marcocancarini/x210ai-rp2040-adapter/doc/CONTESTO_20261102.md

# Contesto di lavoro — 02/11/2026 (chiusura sessione)

## Stato
- Branch `main` allineato a origin (`d398215`). Tutto committato e pushato.
- Misure verticali (calibro/monete): connettore tastiera plugged = 2,1 mm (connettore madre + spina +
  flat 0,2 + stiffener 0,36); luce sopra il plugged ~1,8 mm (5 centesimi entra, 10 no); spazio totale
  dal piano scheda madre al fondo tastiera ~3,9 mm; fuori dal connettore ~5,0 mm tra i piani; sopra il
  quadrato bianco < 1 mm (vietato).
- Foto con dima millimetrata in `riferimenti/misure/` (02/11 e 19/10), rettificata in coordinate dima
  (origine = centro BTB_R_CONN1, scala 24,07 px/mm dai crocini A/C/D). Parsing elementi: slot SIM =
  colonna x −54..−42, y −12,5..4,3; 3 connettori FPC in alto y −26..−14; quadrato bianco vietato
  39,25 × 33 mm (x −27,25..12, y −40,2..−7,2).

## Board C (rev 2.3, in prova) —ape:= integrazione Board A+B, senza cavo eDP
- Si innesta su BTB_R_CONN1 (J2 sotto a 0,0; sopra restano ~1,8 mm → solo PCB sottile), aggira il
  quadrato bianco passando sotto e a sinistra, componenti RP2040 sopra il quadrato (lato opposto a BTB).
- Dime in `doc/`: `x210ai_dima_boardC_1a1.pdf` (v1), `_v2_` (ruotata 90° antiorario, oggetti ruotati
  nelle coordinate dima), `_v3_` (v2 con lati della U tagliati a x = 9 mm, 3 mm sotto la parte superiore
  del quadrato; **v3 è quella buona**, area 2134 mm²), `_v4_` (scartata). Generatore:
  `gen2/gen_dima_giro.py` (`--rot90ccw`, `--v3`, `--v4`). Scala 1:1 verificata (righello 50,09 mm).
- Attenzione: con i nomi corretti, il connettore FPC sinistro risulta a filo (0,00 mm) col braccio R3
  della v3 — da controllare con la prova fisica.

## Prossimi passi
1. Stampare `doc/x210ai_dima_boardC_v3_1a1.pdf` al 100 %, ritagliare, provare su scheda madre
   (frecce rosse al centro di BTB_R_CONN1), verificare FPC sinistro a filo e spazio sopra il quadrato.
2. Se torna, abbozzare il layout della Board C (J2 su BTB, J1 ricettacolo tastiera, RP2040 + flash +
   quarzo + LDO in R4, Q2/Q3/R13/R14, connettore USB) in un nuovo `gen2/design_boardC.py`.
3. Vecchio percorso rev 2.2 (Board A + Board B a scalino + cavo eDP) resta come riferimento in
   `out_boardA/`, `out_boardB/`, `doc/`.
