marcocancarini/x210ai-rp2040-adapter/doc/x210ai_dima_boardC_v4_1a1.pdf

-60

-40

-20

0 | | | 0,4-0,8 mm (~1,8 mm sopra) J2
| | | | BTB_R_CONN1 (spina J2 sotto, a 0,0) | vite
R4 48.5x26.3 | | R1 40.85x16.9 | | | | linguetta vite
| quadrato bianco VIETATO (<1 mm sopra), | 39,3 x 33 mm | | | | connettore | CN1

20

40

R3 14.45x56.7 | R2 7.65x3.4 | flat arancione
| | connettore | FPC
centro BTB_R_CONN1 qui (0,0) | sopra BTB_R_CONN1: solo PCB

slot SIM

50 mm: controlla con il calibro dopo la stampa

Dima di prova 1:1 - Board C (rev 2.3, forma C4): scheda unica a giro del quadrato bianco, coordinate dima mm

Origine (0,0) = centro di BTB_R_CONN1, x verso il palmrest (-x), y verso la vite (+y).

1. Stampa al 100% (senza 'adatta alla pagina') e controlla il righello da 50 mm col calibro.
2. Ritaglia lungo il bordo nero spesso (tieni il pezzo interno).
3. Togli la tastiera. Appoggia il ritaglio con le frecce rosse puntate al centro di BTB_R_CONN1.
4. Il ritaglio NON deve coprire: quadrato bianco (rosso, vietato), FPC, flat, CN1, vite,

linguetta, slot SIM (arancione). Deve coprire solo BTB_R_CONN1 (verde, J2 sotto a 0,0).

5. Sopra BTB_R_CONN1 (tratteggio blu) solo PCB: restano ~1,8 mm; poi prova a rimontare la tastiera.

## X210Ai - dima Board C v2 (forma C4, ruotata 90 gradi antiorario), rev 2.3
