marcocancarini/x210ai-rp2040-adapter/doc/x210ai_cornice_misura_1a1.pdf

Cornice di misura 1:1 per fotografare la zona di BTB_R_CONN1 (coordinate delle dime della Board B, mm)

1. Stampa al 100% (senza 'adatta alla pagina') e controlla il righello da 50 mm col calibro.
2. Ritaglia il bordo esterno e la finestra tratteggiata.
3. Togli la tastiera. Appoggia la cornice sulla scheda madre con BTB_R_CONN1 orizzontale, lo slot SIM

a sinistra e la vite in basso, come nelle dime: il centro del connettore all'incrocio delle frecce rosse

(tacche 0), il lato lungo del connettore parallelo ai righelli in alto e in basso. Fissala con nastro.

4. Fotografa dall'alto, perpendicolare, da 25-30 cm, senza flash e senza ombre: devono vedersi tutta la

cornice, i 4 crocini A-D e i bordi di slot SIM, foro della vite, quadrato bianco e componenti vicini.

Se puoi, fai anche una seconda foto un po' piu' vicina, sempre perpendicolare.

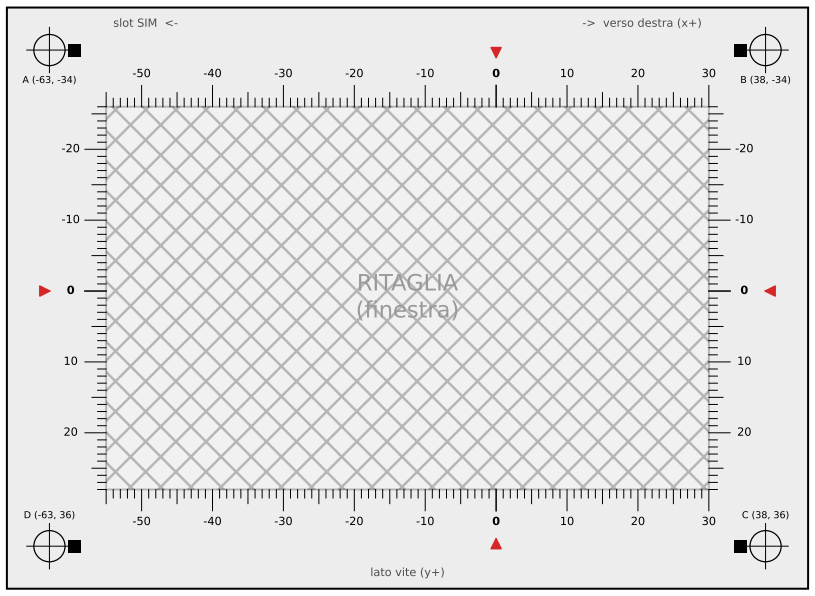
[picture p9: figure]
RITAGLIA (finestra); slot SIM <-; -> verso destra (x+); lato vite (y+)

50 mm: controlla con il calibro dopo la stampa
