marcocancarini/x210ai-rp2040-adapter/doc/x210ai_dima_boardB_scalino_1a1.pdf

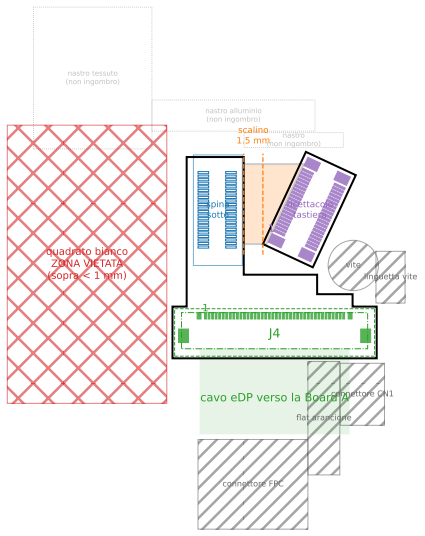
[picture p10: figure]
nastro alluminio (non ingombro); nastro (non ingombro); nastro tessuto (non ingombro); connettore FPC; flat arancione; vite; linguetta vite; connettore CN1; quadrato bianco ZONA VIETATA (sopra < 1 mm); cavo eDP verso la Board A; scalino 1.5 mm; spina sotto; ricettacolo tastiera

scalino
1.5 mm

spina
sotto

J4

1

1

ricettacolo
tastiera

## X210Ai rev 2.2 - dima 1:1 Board B, variante a scalino (palmrest in basso)

PROVA MECCANICA, circuito invariato. Ingombri dalla seconda foto della cornice di misura (28/10).

Orientamento: scheda madre vista dall'alto con il palmrest in BASSO; BTB_R_CONN1 e J4 verticali.

nero: gradino alto (28.8 x 28.4 mm) sulla spina in BTB_R_CONN1 (blu), J4 in basso (verso il palmrest);

arancio: scalino flessibile, scende di 1.5 mm in 2.7 mm (piega a S tra le linee tratteggiate);

viola: ricettacolo della tastiera sul gradino basso, a destra, appoggiato sulla scheda madre, 25 gradi in senso orario;

verde: J4 eDP e spina/fascio del cavo; grigio: ingombri; rosso: zona vietata; puntinato: nastri

Legenda completa dei componenti: x210ai_dima_boardB_scalino_legenda.pdf

margini: gradino alto - flat arancione 0.4 mm; gradino basso - vite 1.5 mm; gradino alto - quadrato bianco 0.8 mm; larghezza tratto flessibile 11.3 mm

Copia in basso: ritaglia il contorno nero (scalino compreso), piega a Z sulle linee arancio in modo che

il gradino basso scenda di 1.5 mm, appoggia la parte alta su BTB_R_CONN1 (pin 1 come in serigrafia)

e controlla: niente sopra il quadrato bianco, gradino basso libero accanto alla vite, spina della tastiera

che arriva sul ricettacolo viola,

spazio sopra il gradino basso per spina + flat (circa 2,9 mm dalla scheda madre), spazio sopra J4

(circa 3,0 mm dalla scheda madre) e strada libera per il cavo eDP.

Stampa al 100% (senza 'adatta alla pagina').

da ritagliare (scalino disteso):

palmrest (in basso) 50 mm: controlla con il calibro
