marcocancarini/x210ai-rp2040-adapter/doc/x210ai_dima_boardB_1a1.pdf

slot SIM

vite

quadrato bianco

Q3 R14 Q2 R13

J1

J4 | 1

uscita cavo eDP

50 mm: controlla con il calibro dopo la stampa

## X210Ai rev 2.2 - dima 1:1 Board B

nero: contorno Board B a L 39.7 x 15.4 mm, vista dall'alto (piazzamento PRELIMINARE)

rosso puntinato: ingombro della rev 2.0 (29 mm a sinistra del centro del connettore)

tratteggio grigio: ostacoli misurati dalla foto (slot SIM, vite, quadrato bianco), +/-0,5 mm

blu: J1 sandwich centrato su BTB_R_CONN1 (pieno = sopra, vuoto = spina sotto)

verde chiaro: fascio del cavo eDP (non fa parte della scheda: NON ritagliare)

margini: slot SIM (in x) 0.7 mm; vite (in y) 4.0 mm; quadrato bianco (in y) 1.5 mm; cavo - J1 (in x) 0.5 mm; J4 - J1 (in y) 0.5 mm

Ritaglia il contorno nero e appoggialo con J1 sul connettore (pin 1 come in serigrafia).

verde: ricettacolo eDP 20455-040E, tratteggio = area libera 28,2 x 6,7 mm (barra di sgancio)

grigio: altri componenti (pieno = sopra, vuoto = sotto)

Stampa al 100% (senza 'adatta alla pagina').
