marcocancarini/x210ai-rp2040-adapter/doc/x210ai_dima_boardB_L_1a1.pdf

slot SIM

vite

quadrato bianco

cavo eDP 21 mm

J1

J4

1

Q3 R14 Q2 R13

cavo eDP 21 mm

J1

J4

1

Q3 R14 Q2 R13

## X210Ai rev 2.2 - dima 1:1 Board B, variante a L rovesciata

nero: contorno Board B a L rovesciata, 39.7 x 15.4 mm, vista dall'alto (PROVA MECCANICA, circuito invariato)

rosso puntinato: contorno attuale della Board B (design_boardB.py), per confronto

tratteggio grigio: ostacoli misurati dalla foto (slot SIM, vite, quadrato bianco), +/-0,5 mm

blu: J1 sandwich su BTB_R_CONN1; verde: J4 ruotato 180 gradi, pin 1 a destra

verde tratto-punto: spina innestata; verde chiaro: fascio del cavo che sale a sinistra di J1

margini: slot SIM (in x) 0.7 mm; vite (in y) 4.0 mm; quadrato bianco (in y) 1.5 mm; cavo - J1 (in x) 0.5 mm; J4 - J1 (in y) 0.5 mm

Copia in basso: ritaglia SOLO il contorno nero, appoggia J1 sul connettore (pin 1 come in

serigrafia). Per il cavo ritaglia una striscia di carta larga 21 mm e posala sulla zona verde.

Stampa al 100% (senza 'adatta alla pagina').

da ritagliare:

50 mm: controlla con il calibro dopo la stampa
