marcocancarini/x210ai-rp2040-adapter/pcb_out4/p4_bottom.png

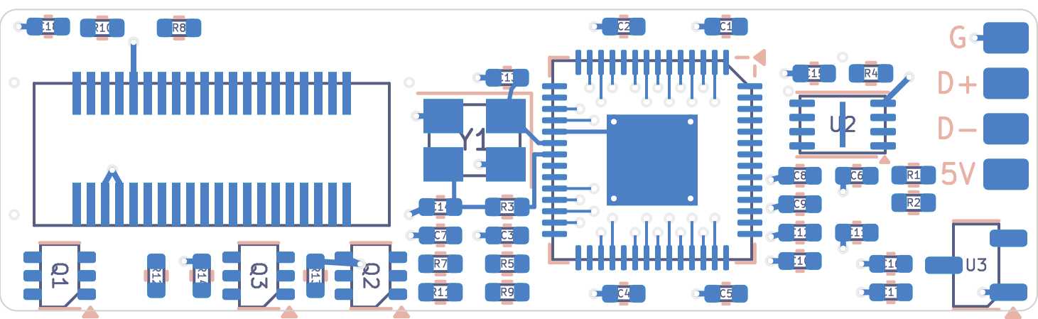
pcb_out4/p4_bottom.png
