marcocancarini/x210ai-rp2040-adapter/riferimenti/misure/foto_20261102_rettificata_mm.jpg

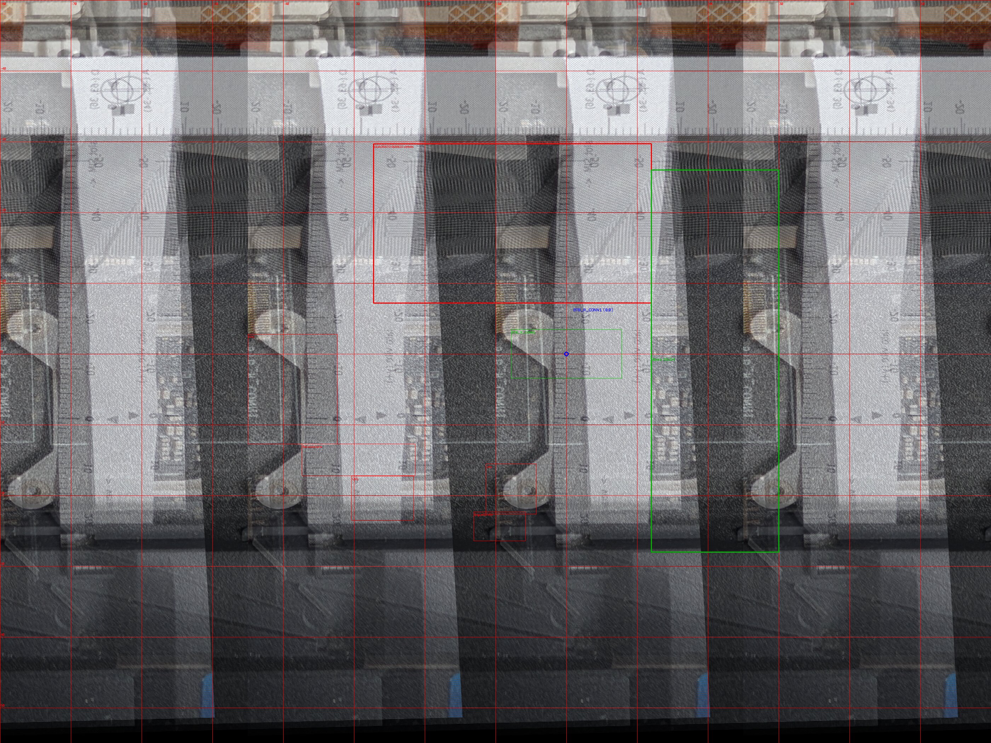
riferimenti/misure/foto_20261102_rettificata_mm.jpg
