marcocancarini/x210ai-rp2040-adapter/riferimenti/misure/PXL_20261019_233538594.jpg

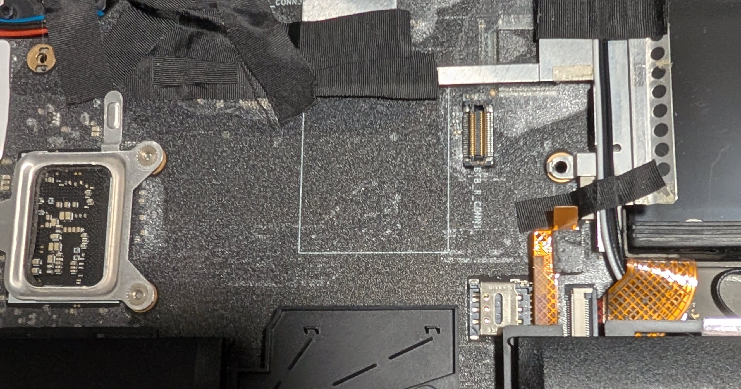
riferimenti/misure/PXL_20261019_233538594.jpg
