marcocancarini/x210ai-rp2040-adapter/riferimenti/misure/PXL_20261102_114706251.jpg

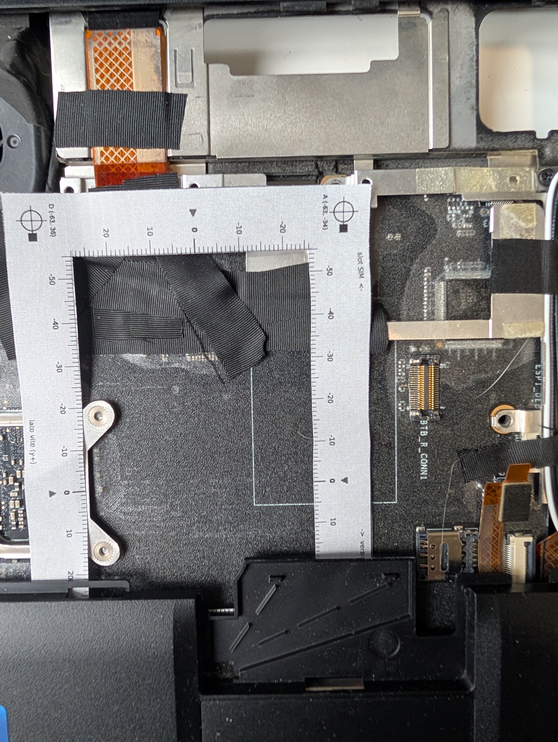
riferimenti/misure/PXL_20261102_114706251.jpg
