marcocancarini/x210ai-rp2040-adapter/sch/sch_prev-1.png

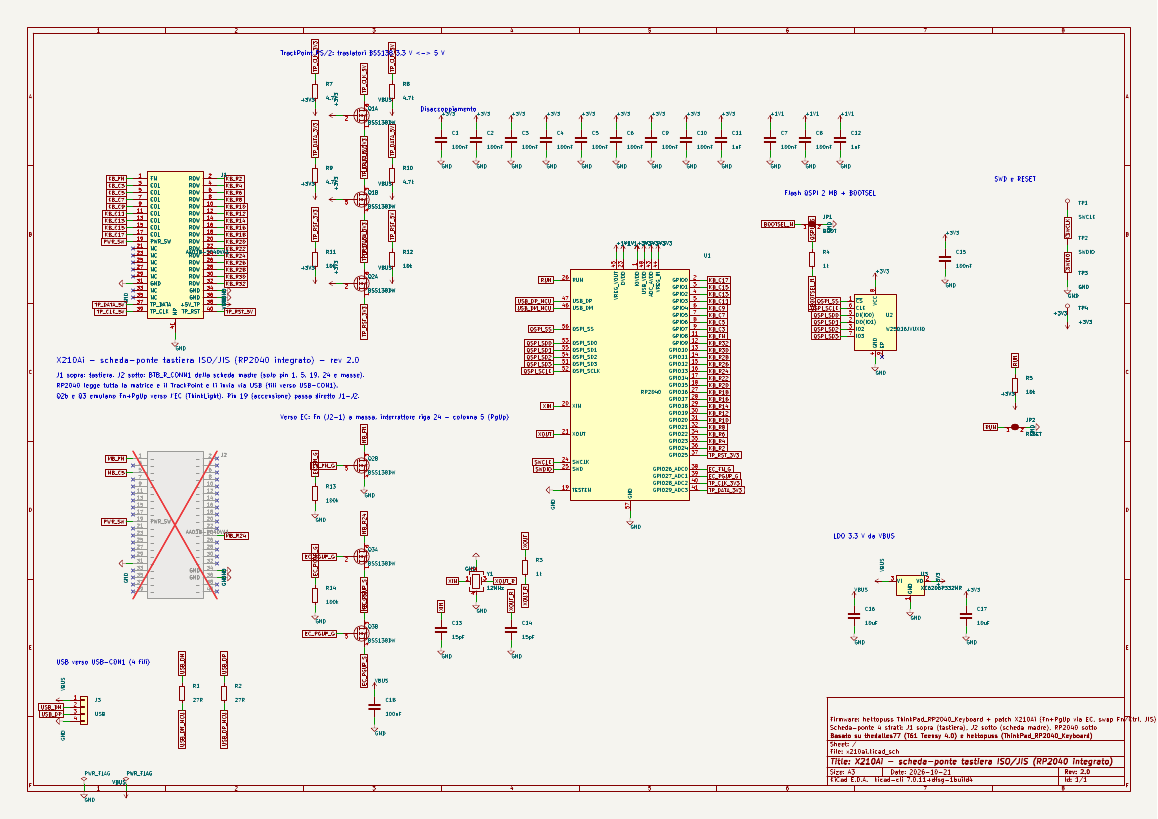
sch/sch_prev-1.png
