marcocancarini/x210ai-rp2040-adapter/spice2/sim_ec_switch.png

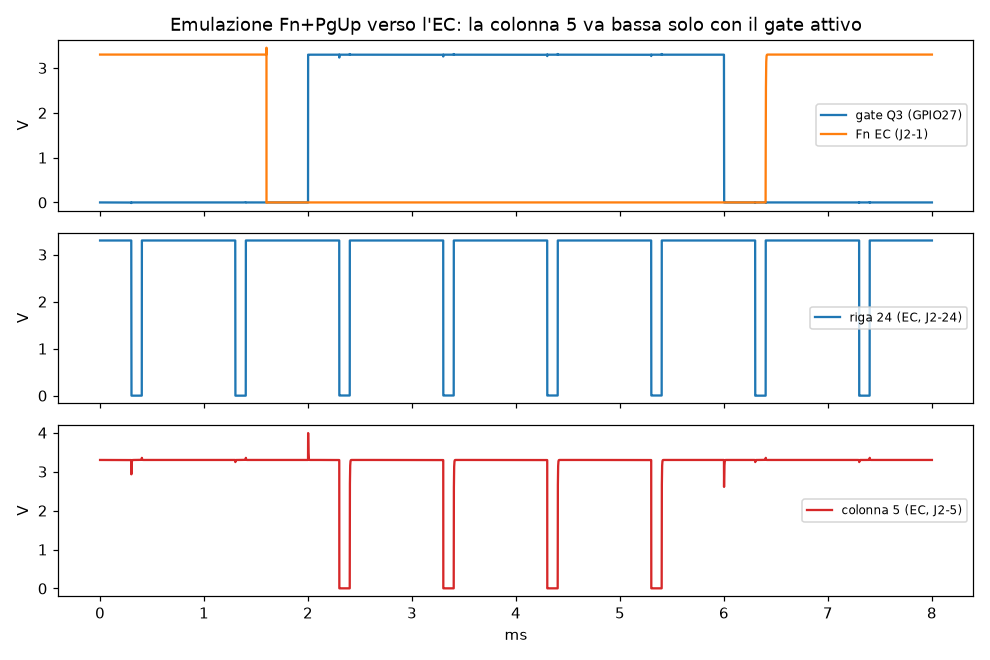
spice2/sim_ec_switch.png
