marcocancarini/x210ai-rp2040-adapter/produzione/boardB/x210ai_rev2.2_boardB_bom_jlcpcb_bottom_e_top.csv

Comment | Designator | Footprint | LCSC Part #
AA01B-S040VA1 | J1 | JAE_AA01B-S040VA1_T61_GND41 | C2938571
20455-040E-76 | J4 | IPEX_20455-040E_90deg | C5160883
BSS138DW | Q2,Q3 | SOT-363_SC-70-6_Tight | C154900
100k | R13,R14 | R_0402_1005Metric | C25741
