marcocancarini/x210ai-rp2040-adapter/doc/x210ai_dima_boardA_1a1.pdf

## X210Ai rev 2.2 - dima 1:1 Board A

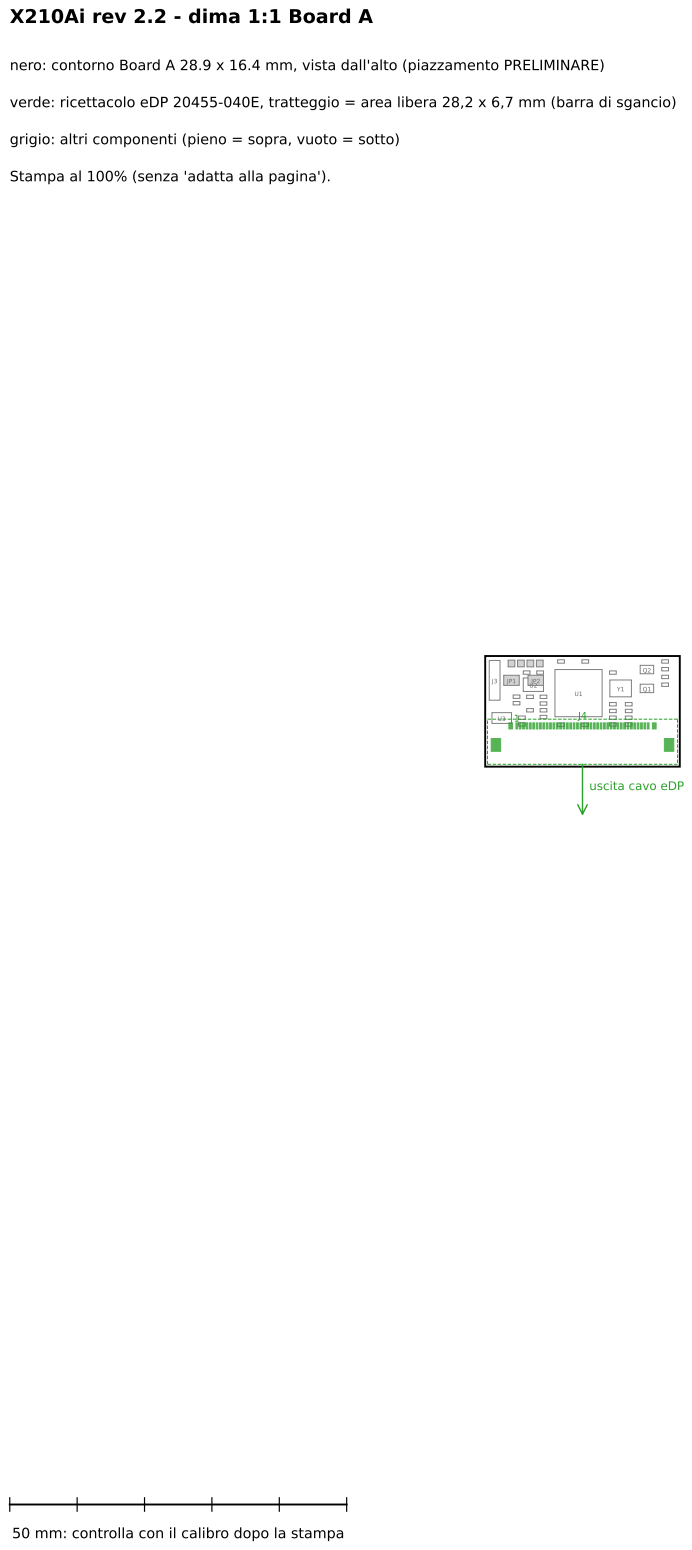
[picture p17: page 1]

nero: contorno Board A 28.9 x 16.4 mm, vista dall'alto (piazzamento PRELIMINARE)

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

grigio: altri componenti (pieno = sopra, vuoto = sotto)

Stampa al 100% (senza 'adatta alla pagina').

50 mm: controlla con il calibro dopo la stampa
