marcocancarini/x210ai-rp2040-adapter/(list of files, drawings)

Other design files:
out_boardA/x210ai_boardA.dsn
out_boardB/x210ai_boardB.dsn
