marcocancarini/x210ai-rp2040-adapter/out_boardB/x210ai_boardB.kicad_pcb

## KiCad design out_boardB/x210ai_boardB.kicad_pcb (2026-10-28)

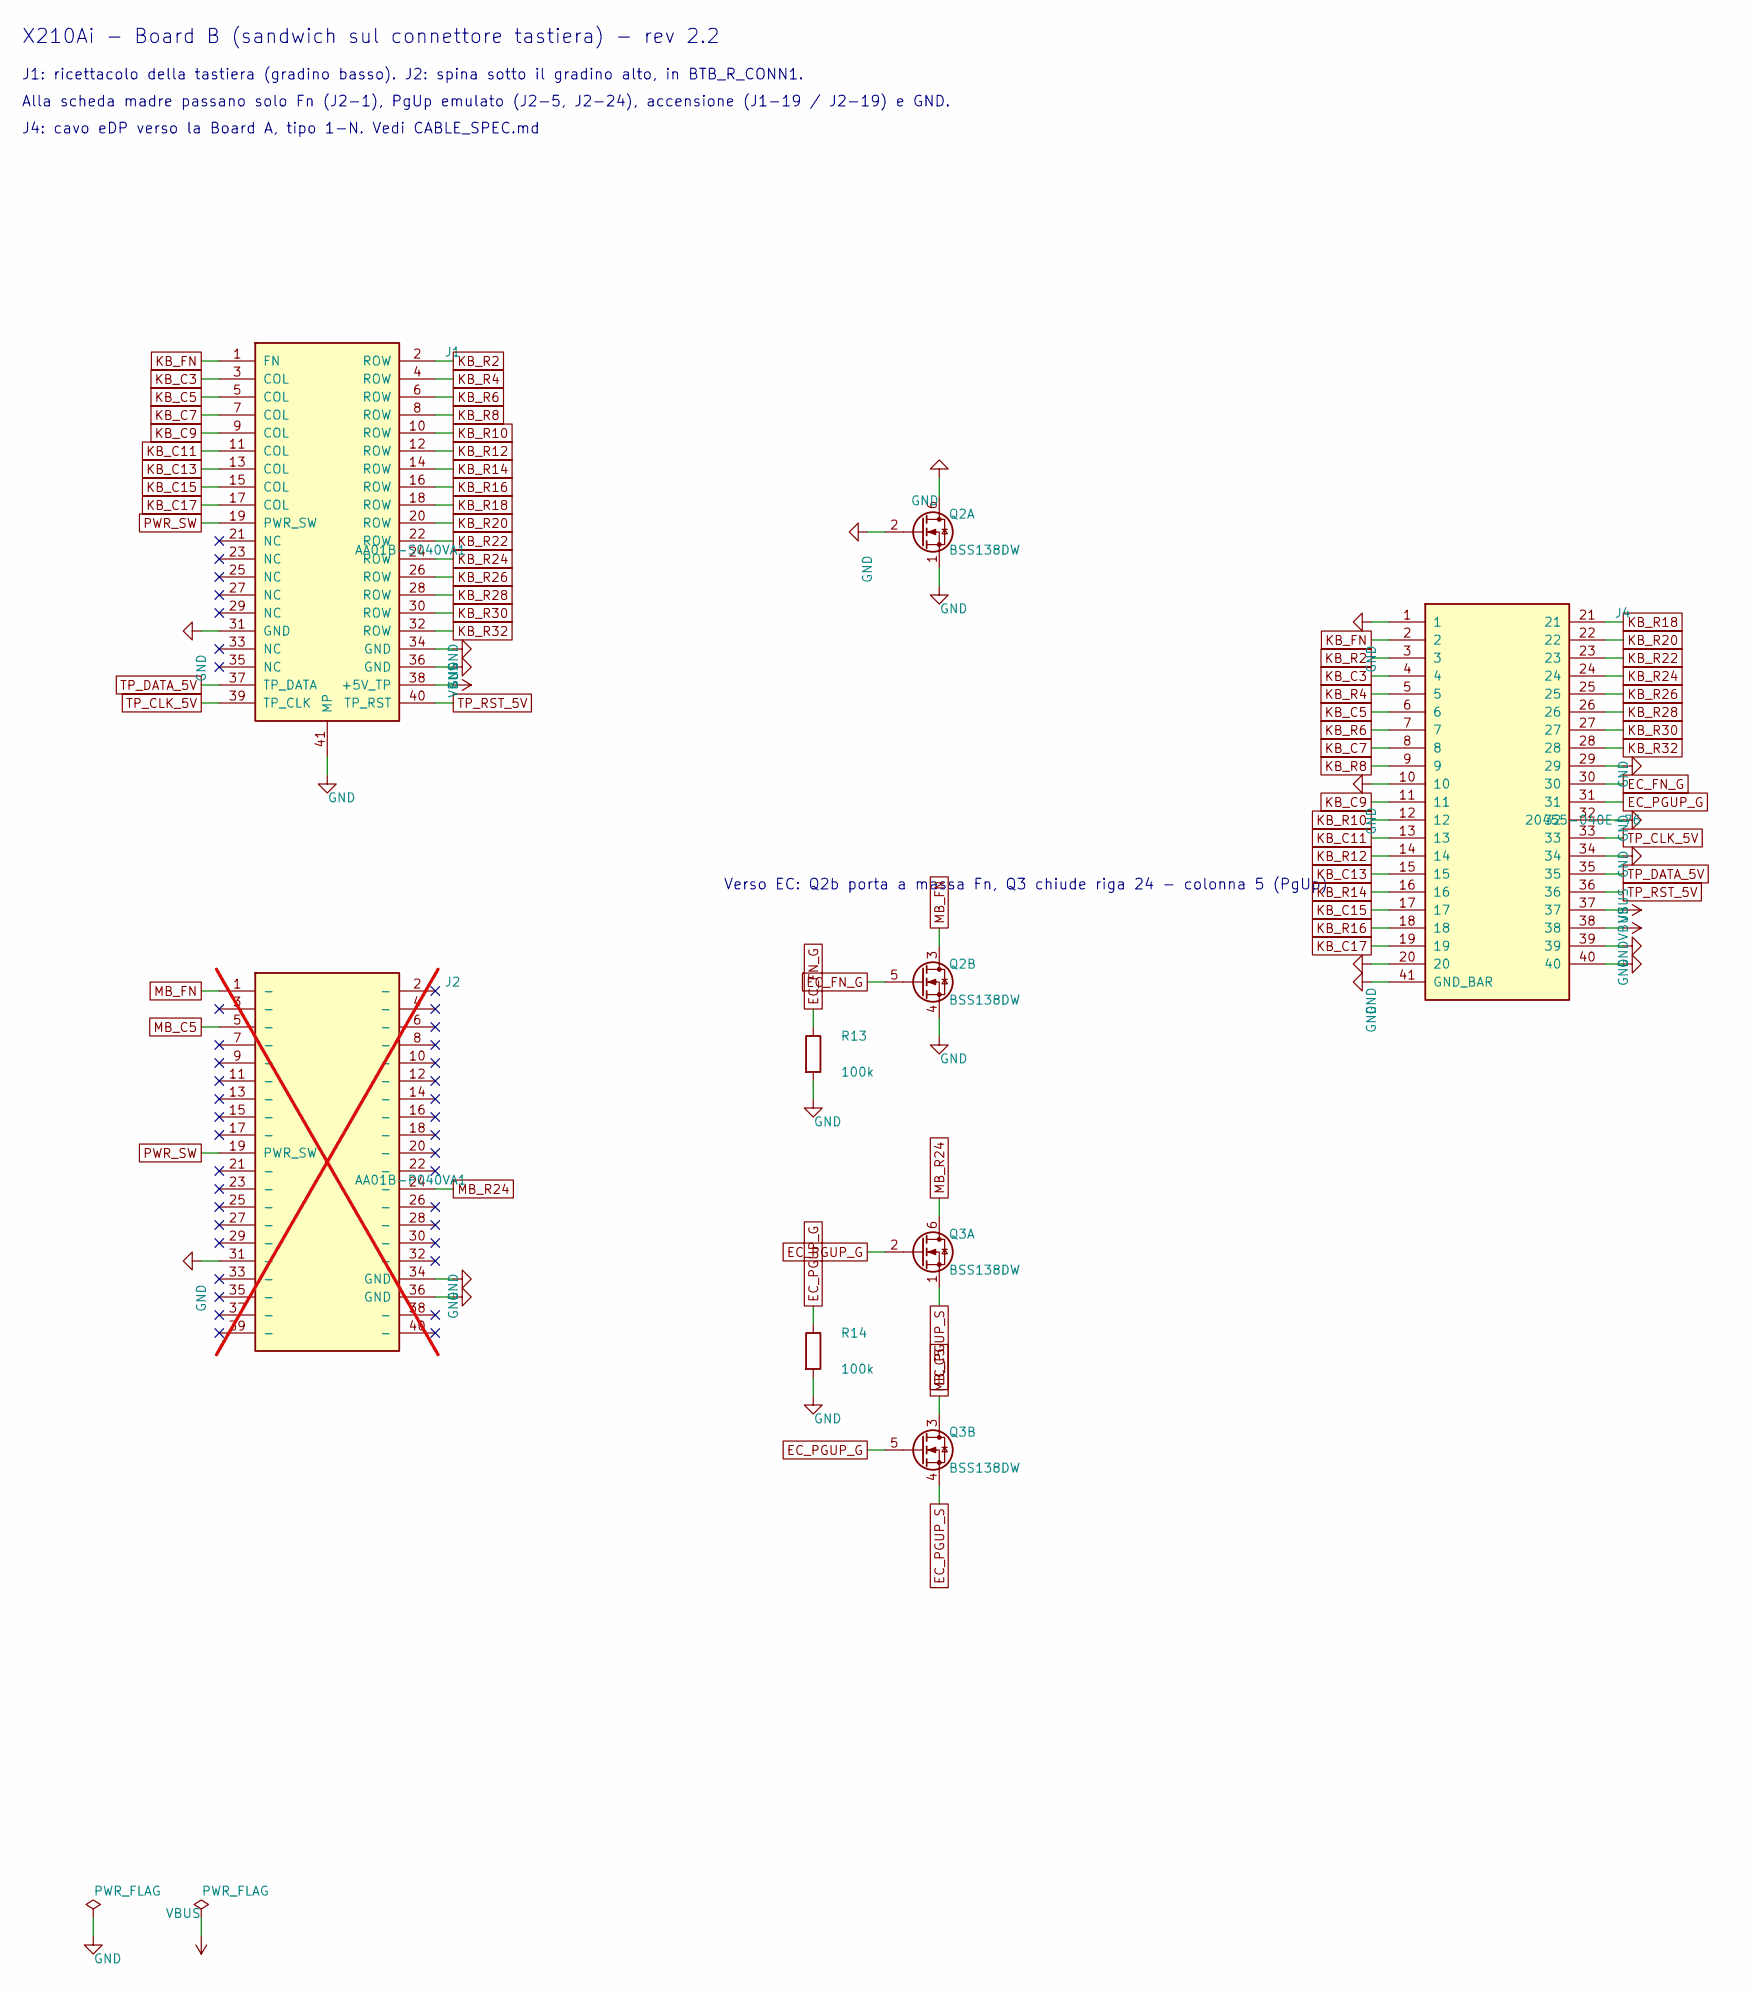
[picture p19: schematic x210ai_boardB.kicad_sch, X210Ai - Board B (sandwich sul connettore tastiera)]

Parts:
J1: AA01B-S040VA1; JAE_AA01B-S040VA1_T61_GND41; MPN AA01B-S040VA1-R3000; LCSC C2938571
J2: AA01B-P040VA1; JAE_AA01B-P040_MB_Plug_Bottom; MPN AA01B-P040VA1-R3000 (o spina 2x22 recup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; not fitted
J4: 20455-040E-76; IPEX_20455-040E_90deg; MPN 20455-040E-76; LCSC C5160883
Q2, Q3: BSS138DW; SOT-363_SC-70-6_Tight; MPN BSS138DW-7-F; LCSC C154900
R13, R14: 100k; R_0402_1005Metric; MPN 0402WGF1003TCE; LCSC C25741

Connections:
EC_FN_G: J4.30, Q2.5 (G), R13.1
EC_PGUP_G: J4.31, Q3.2 (G), Q3.5 (G), R14.1
EC_PGUP_S: Q3.1 (S), Q3.4 (S)
GND: J1.31 (GND), J1.34 (GND), J1.36 (GND), J1.41 (MP), J2.31 (-), J2.34 (GND), J2.36 (GND), J4.1, J4.10, J4.20, J4.29, J4.32, J4.34, J4.39, J4.40, J4.41 (GND_BAR), Q2.1 (S), Q2.2 (G), Q2.4 (S), Q2.6 (D), R13.2, R14.2
KB_C3: J1.3 (COL), J4.4
KB_C5: J1.5 (COL), J4.6
KB_C7: J1.7 (COL), J4.8
KB_C9: J1.9 (COL), J4.11
KB_C11: J1.11 (COL), J4.13
KB_C13: J1.13 (COL), J4.15
KB_C15: J1.15 (COL), J4.17
KB_C17: J1.17 (COL), J4.19
KB_FN: J1.1 (FN), J4.2
KB_R2: J1.2 (ROW), J4.3
KB_R4: J1.4 (ROW), J4.5
KB_R6: J1.6 (ROW), J4.7
KB_R8: J1.8 (ROW), J4.9
KB_R10: J1.10 (ROW), J4.12
KB_R12: J1.12 (ROW), J4.14
KB_R14: J1.14 (ROW), J4.16
KB_R16: J1.16 (ROW), J4.18
KB_R18: J1.18 (ROW), J4.21
KB_R20: J1.20 (ROW), J4.22
KB_R22: J1.22 (ROW), J4.23
KB_R24: J1.24 (ROW), J4.24
KB_R26: J1.26 (ROW), J4.25
KB_R28: J1.28 (ROW), J4.26
KB_R30: J1.30 (ROW), J4.27
KB_R32: J1.32 (ROW), J4.28
MB_C5: J2.5 (-), Q3.3 (D)
MB_FN: J2.1 (-), Q2.3 (D)
MB_R24: J2.24 (-), Q3.6 (D)
PWR_SW: J1.19 (PWR_SW), J2.19 (PWR_SW)
TP_CLK_5V: J1.39 (TP_CLK), J4.33
TP_DATA_5V: J1.37 (TP_DATA), J4.35
TP_RST_5V: J1.40 (TP_RST), J4.36
VBUS: J1.38 (+5V_TP), J4.37, J4.38

Notes on the sheet:
X210Ai - Board B (sandwich sul connettore tastiera) - rev 2.2
J1: ricettacolo della tastiera (gradino basso). J2: spina sotto il gradino alto, in BTB_R_CONN1.
Alla scheda madre passano solo Fn (J2-1), PgUp emulato (J2-5, J2-24), accensione (J1-19 / J2-19) e GND.
J4: cavo eDP verso la Board A, tipo 1-N. Vedi CABLE_SPEC.md
Verso EC: Q2b porta a massa Fn, Q3 chiude riga 24 - colonna 5 (PgUp)

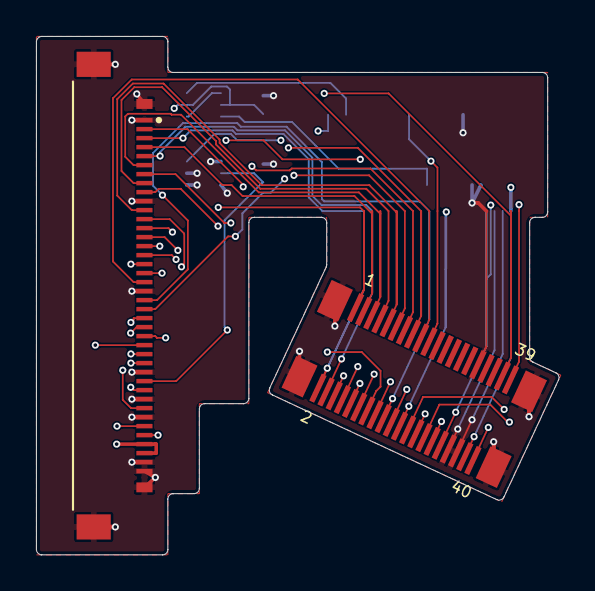
[picture p20: board x210ai_boardB.kicad_pcb from above]

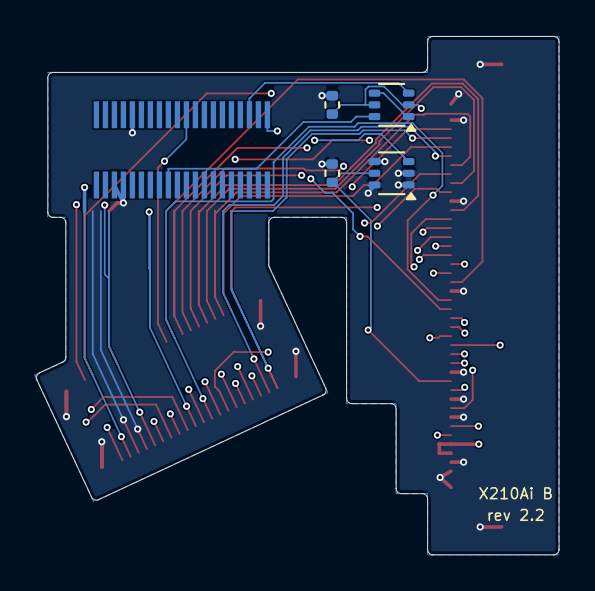
[picture p21: board x210ai_boardB.kicad_pcb from below]

Board: 4 copper layers, 29.0 x 28.8 mm, 7 parts (5 on the bottom side), 37 nets.
