marcocancarini/x210ai-rp2040-adapter/out_boardA/x210ai_boardA.kicad_pcb

## KiCad design out_boardA/x210ai_boardA.kicad_pcb (2026-10-28)

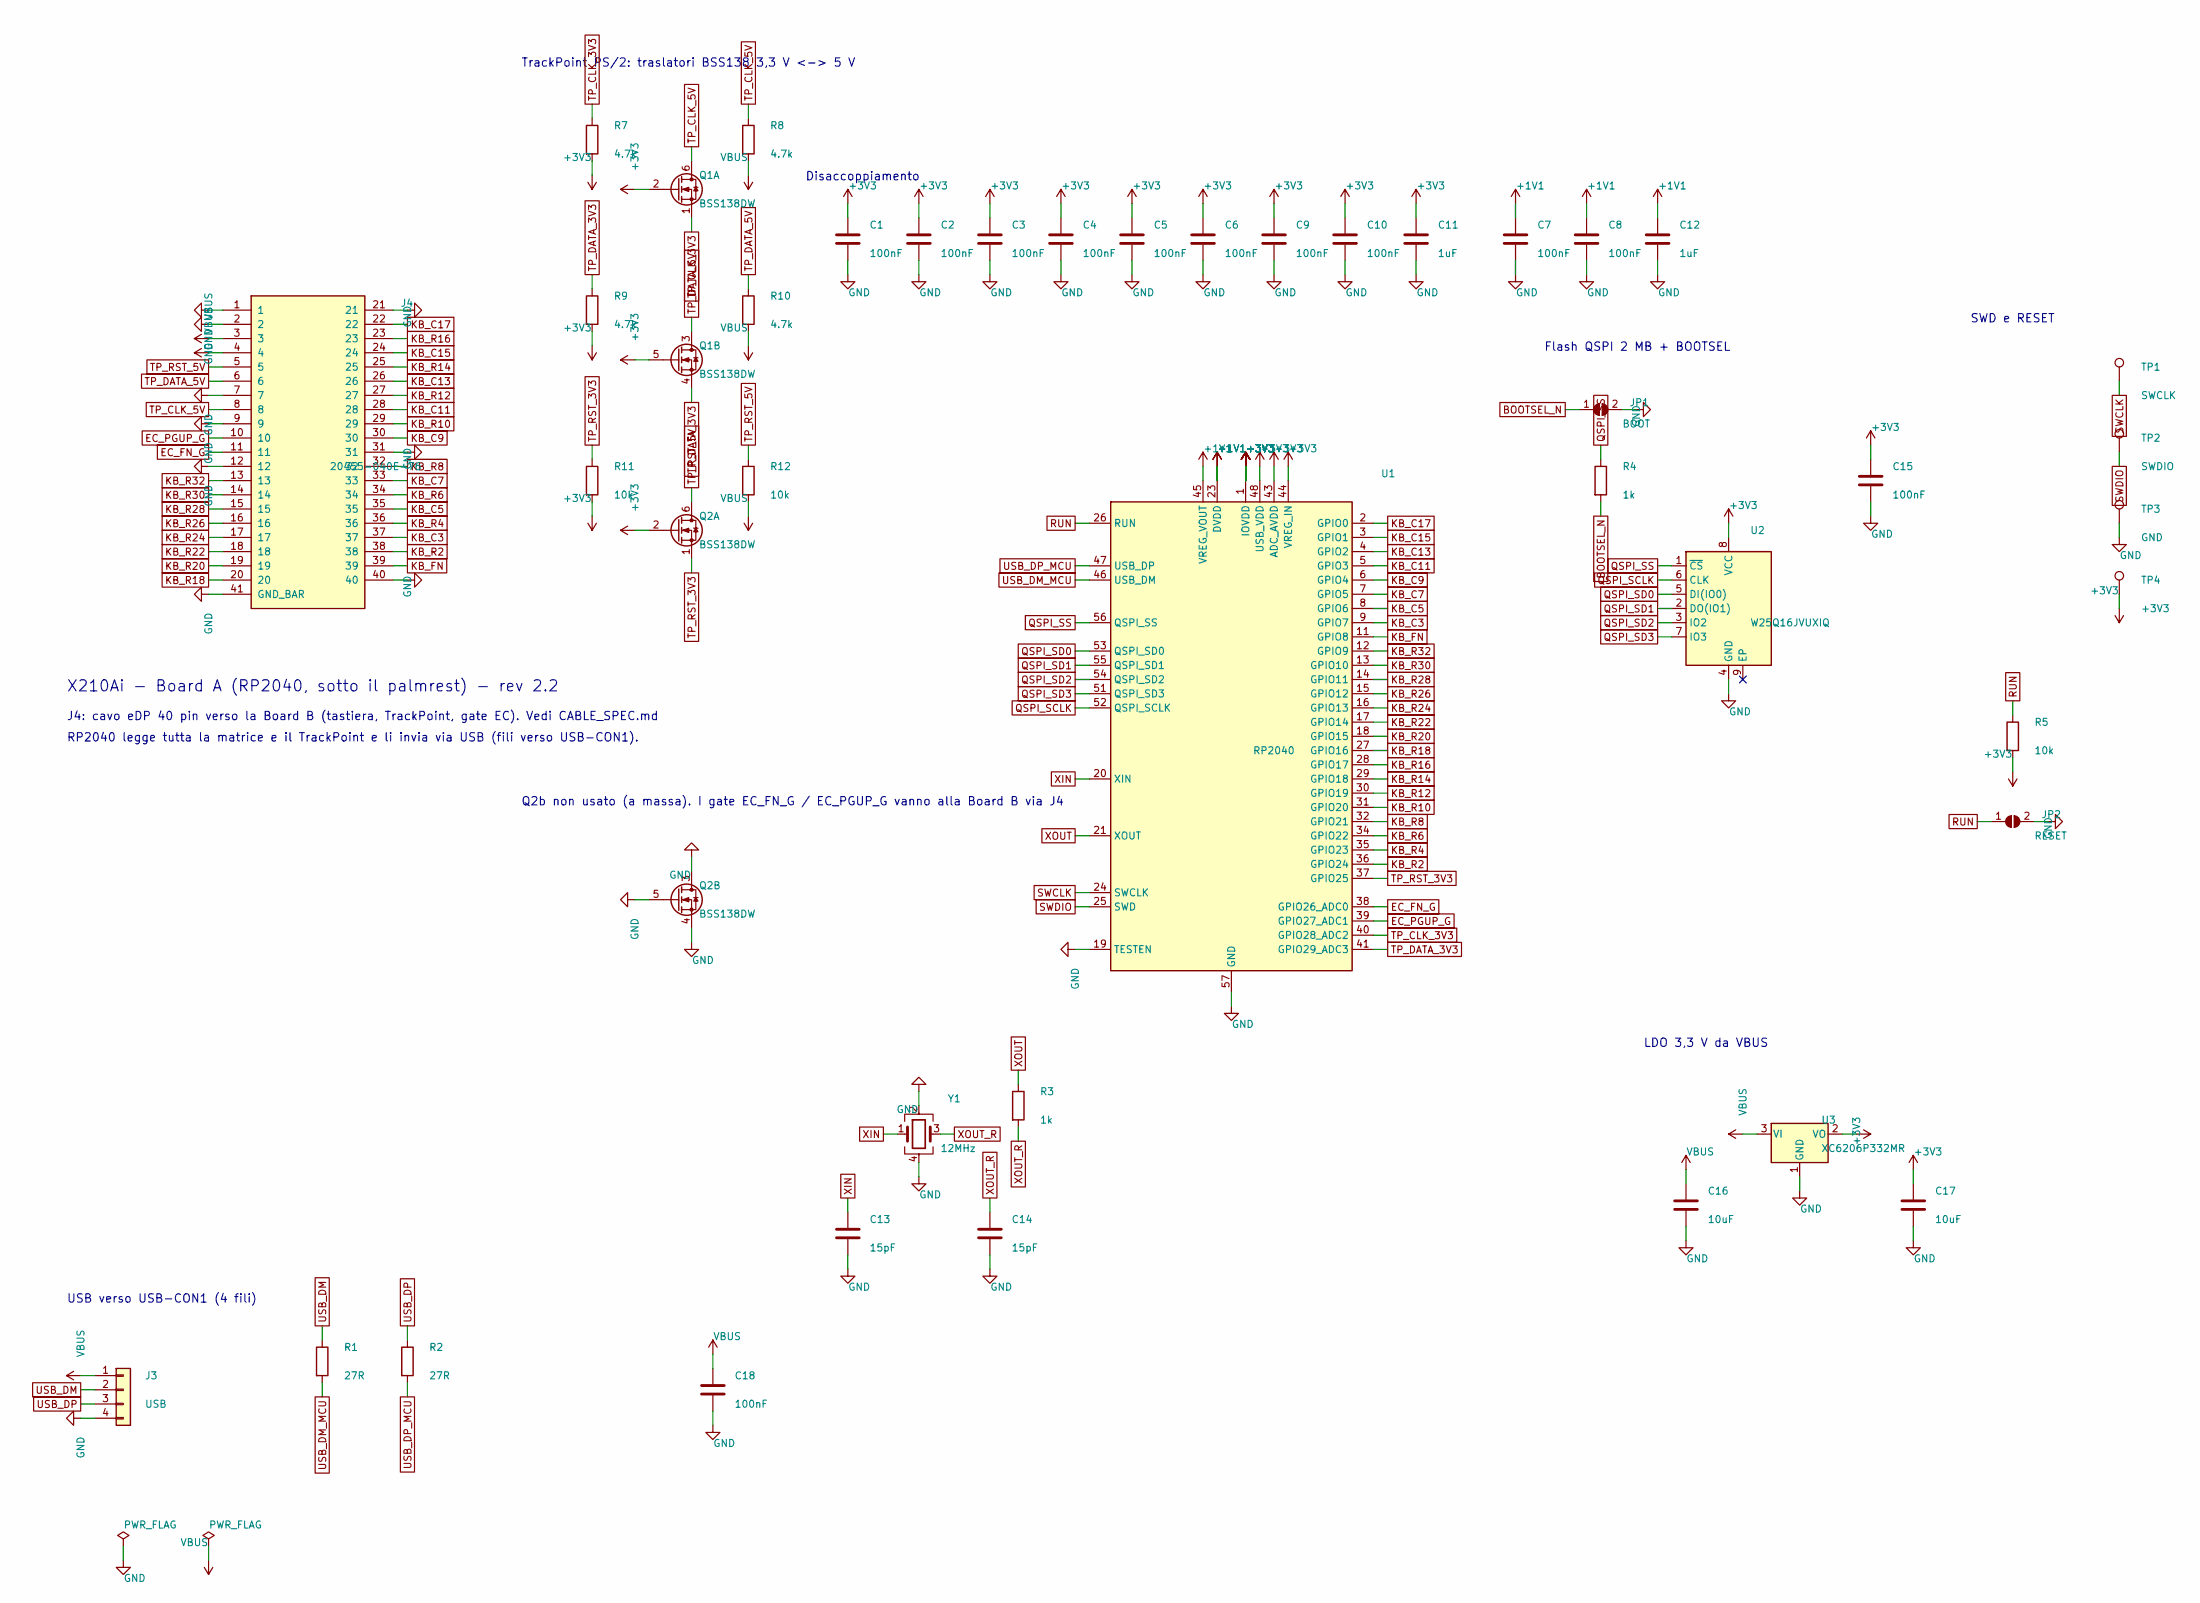
[picture p22: schematic x210ai_boardA.kicad_sch, X210Ai - Board A (RP2040, sotto il palmrest)]

Parts:
C1, C2, C3, C4, C5, C6, C7, C8, C9, C10, C15, C18: 100nF; C_0402_1005Metric; MPN CL05B104KO5NNNC; LCSC C1525
C11, C12: 1uF; C_0402_1005Metric; MPN CL05A105KA5NQNC; LCSC C52923
C13, C14: 15pF; C_0402_1005Metric; MPN CL05C150JB5NNNC; LCSC C1548
C16, C17: 10uF; C_0402_1005Metric; MPN CL05A106MQ5NUNC; LCSC C15525
J3: USB; Pads_1x04_P1.60mm_Wire_Edge
J4: 20455-040E-76; IPEX_20455-040E_90deg; MPN 20455-040E-76; LCSC C5160883
JP1: BOOT; SolderJumper-2_P1.3mm_Open_RoundedPad1.0x1.5mm
JP2: RESET; SolderJumper-2_P1.3mm_Open_RoundedPad1.0x1.5mm
Q1, Q2: BSS138DW; SOT-363_SC-70-6_Tight; MPN BSS138DW-7-F; LCSC C154900
R1, R2: 27R; R_0402_1005Metric; MPN 0402WGF270JTCE; LCSC C25100
R3, R4: 1k; R_0402_1005Metric; MPN 0402WGF1001TCE; LCSC C11702
R5, R11, R12: 10k; R_0402_1005Metric; MPN 0402WGF1002TCE; LCSC C25744
R7, R8, R9, R10: 4.7k; R_0402_1005Metric; MPN 0402WGF4701TCE; LCSC C25900
TP1: SWCLK; TP_Pad_1.0x1.0mm
TP2: SWDIO; TP_Pad_1.0x1.0mm
TP3: GND; TP_Pad_1.0x1.0mm
TP4: +3V3; TP_Pad_1.0x1.0mm
U1: RP2040; QFN-56-1EP_7x7mm_P0.4mm_EP3.2x3.2mm_ThermalVias; MPN RP2040; LCSC C2040
U2: W25Q16JVUXIQ; Winbond_USON-8-1EP_3x2mm_P0.5mm_EP0.2x1.6mm; MPN W25Q16JVUXIQ; LCSC C2843335
U3: XC6206P332MR; SOT-23-3; MPN XC6206P332MR-G; LCSC C5446
Y1: 12MHz; Crystal_SMD_3225-4Pin_3.2x2.5mm; MPN ABM8-272-T3; LCSC C20625731

Connections:
+1V1: C7.1, C8.1, C12.1, U1.23 (DVDD), U1.45 (VREG_VOUT), U1.50 (DVDD)
+3V3: C1.1, C2.1, C3.1, C4.1, C5.1, C6.1, C9.1, C10.1, C11.1, C15.1, C17.1, Q1.2 (G), Q1.5 (G), Q2.2 (G), R5.2, R7.2, R9.2, R11.2, TP4.1, U1.1 (IOVDD), U1.10 (IOVDD), U1.22 (IOVDD), U1.33 (IOVDD), U1.42 (IOVDD), U1.43 (ADC_AVDD), U1.44 (VREG_IN), U1.48 (USB_VDD), U1.49 (IOVDD), U2.8 (VCC), U3.2 (VO)
BOOTSEL_N: JP1.1 (A), R4.2
EC_FN_G: J4.11, U1.38 (GPIO26_ADC0)
EC_PGUP_G: J4.10, U1.39 (GPIO27_ADC1)
GND: C1.2, C2.2, C3.2, C4.2, C5.2, C6.2, C7.2, C8.2, C9.2, C10.2, C11.2, C12.2, C13.2, C14.2, C15.2, C16.2, C17.2, C18.2, J3.4, J4.1, J4.2, J4.7, J4.9, J4.12, J4.21, J4.31, J4.40, J4.41 (GND_BAR), JP1.2 (B), JP2.2 (B), Q2.3 (D), Q2.4 (S), Q2.5 (G), TP3.1, U1.19 (TESTEN), U1.57 (GND), U2.4 (GND), U3.1 (GND), Y1.2, Y1.4
KB_C3: J4.37, U1.9 (GPIO7)
KB_C5: J4.35, U1.8 (GPIO6)
KB_C7: J4.33, U1.7 (GPIO5)
KB_C9: J4.30, U1.6 (GPIO4)
KB_C11: J4.28, U1.5 (GPIO3)
KB_C13: J4.26, U1.4 (GPIO2)
KB_C15: J4.24, U1.3 (GPIO1)
KB_C17: J4.22, U1.2 (GPIO0)
KB_FN: J4.39, U1.11 (GPIO8)
KB_R2: J4.38, U1.36 (GPIO24)
KB_R4: J4.36, U1.35 (GPIO23)
KB_R6: J4.34, U1.34 (GPIO22)
KB_R8: J4.32, U1.32 (GPIO21)
KB_R10: J4.29, U1.31 (GPIO20)
KB_R12: J4.27, U1.30 (GPIO19)
KB_R14: J4.25, U1.29 (GPIO18)
KB_R16: J4.23, U1.28 (GPIO17)
KB_R18: J4.20, U1.27 (GPIO16)
KB_R20: J4.19, U1.18 (GPIO15)
KB_R22: J4.18, U1.17 (GPIO14)
KB_R24: J4.17, U1.16 (GPIO13)
KB_R26: J4.16, U1.15 (GPIO12)
KB_R28: J4.15, U1.14 (GPIO11)
KB_R30: J4.14, U1.13 (GPIO10)
KB_R32: J4.13, U1.12 (GPIO9)
QSPI_SCLK: U1.52 (QSPI_SCLK), U2.6 (CLK)
QSPI_SD0: U1.53 (QSPI_SD0), U2.5 (DI(IO0))
QSPI_SD1: U1.55 (QSPI_SD1), U2.2 (DO(IO1))
QSPI_SD2: U1.54 (QSPI_SD2), U2.3 (IO2)
QSPI_SD3: U1.51 (QSPI_SD3), U2.7 (IO3)
QSPI_SS: R4.1, U1.56 (QSPI_SS), U2.1 (~CS)
RUN: JP2.1 (A), R5.1, U1.26 (RUN)
SWCLK: TP1.1, U1.24 (SWCLK)
SWDIO: TP2.1, U1.25 (SWD)
TP_CLK_3V3: Q1.1 (S), R7.1, U1.40 (GPIO28_ADC2)
TP_CLK_5V: J4.8, Q1.6 (D), R8.1
TP_DATA_3V3: Q1.4 (S), R9.1, U1.41 (GPIO29_ADC3)
TP_DATA_5V: J4.6, Q1.3 (D), R10.1
TP_RST_3V3: Q2.1 (S), R11.1, U1.37 (GPIO25)
TP_RST_5V: J4.5, Q2.6 (D), R12.1
USB_DM: J3.2, R1.1
USB_DM_MCU: R1.2, U1.46 (USB_DM)
USB_DP: J3.3, R2.1
USB_DP_MCU: R2.2, U1.47 (USB_DP)
VBUS: C16.1, C18.1, J3.1, J4.3, J4.4, R8.2, R10.2, R12.2, U3.3 (VI)
XIN: C13.1, U1.20 (XIN), Y1.1
XOUT: R3.1, U1.21 (XOUT)
XOUT_R: C14.1, R3.2, Y1.3

Notes on the sheet:
X210Ai - Board A (RP2040, sotto il palmrest) - rev 2.2
RP2040 legge tutta la matrice e il TrackPoint e li invia via USB (fili verso USB-CON1).
TrackPoint PS/2: traslatori BSS138 3,3 V <-> 5 V
Disaccoppiamento
Flash QSPI 2 MB + BOOTSEL
LDO 3,3 V da VBUS
USB verso USB-CON1 (4 fili)
SWD e RESET
J4: cavo eDP 40 pin verso la Board B (tastiera, TrackPoint, gate EC). Vedi CABLE_SPEC.md
Q2b non usato (a massa). I gate EC_FN_G / EC_PGUP_G vanno alla Board B via J4

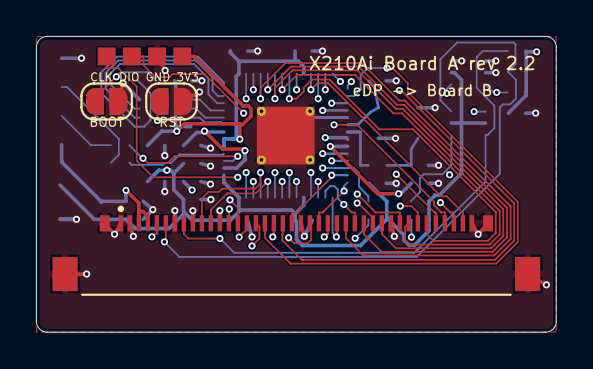
[picture p23: board x210ai_boardA.kicad_pcb from above]

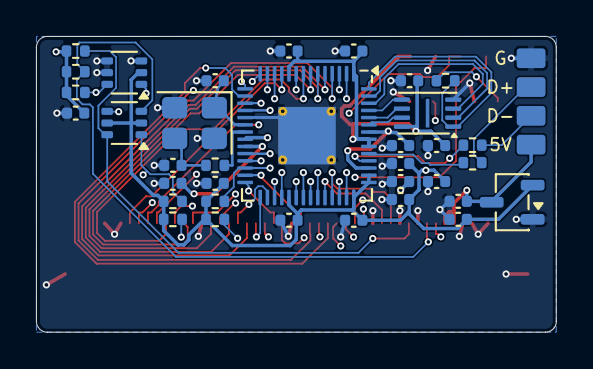
[picture p24: board x210ai_boardA.kicad_pcb from below]

Board: 4 copper layers, 28.9 x 16.4 mm, 43 parts (36 on the bottom side), 54 nets.
