marcocancarini/x210ai-rp2040-adapter/(commit log)

2026-10-28 X210Ai rev 2.2: stato del progetto (due schede) + dima Board B a L rovesciata
    [T61.brd, T61.sch, routed_p.kicad_pcb, x210ai.kicad_sch, x210ai_boardA.kicad_sch, x210ai_boardB.kicad_sch, x210ai_rev2.2_boardA_bom_completa_mpn.csv, x210ai_rev2.2_boardA_bom_jlcpcb.csv]
2026-10-28 README con checklist; riferimenti ridotti ai file usati dagli script
    [T61.sch]
2026-10-28 gitignore: log di Freerouting
2026-10-28 rev 2.2: Board A e Board B sbrogliate, produzione su JLCPCB
    - Board B a L rovesciata (39,7 x 15,4 mm) nel modello, contorno e zone a poligono
    - Board A compattata a 28,9 x 16,4 mm; via +3V3 per U1.48/49, pad 19 fuori zona
    - Sbroglio Freerouting di entrambe le schede: ERC 0, DRC 0, 0 non connessi,
    schema = PCB; Gerber, forature, BOM e CPL in produzione/boardA|boardB
    - DSN: isolamento alzato per rispettare 0,2 mm foro-rame
    - KiCad 10: simboli in libreria di progetto x210ai, Q_Dual da Transistor_FET,
    campi BOM nascosti in serigrafia, testo speculare sul lato B, dfm_check portato
    - Produttore: JLCPCB per entrambe (Board B 0,4 mm, solo ENIG, niente pannello)
    - Dime 1:1 aggiornate; README e do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
    [01_piazzato.kicad_pcb, 02_sbrogliato.kicad_pcb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]
2026-10-28 rev 2.2 v2.2.0-rc1: documenti rev 2.2, assemblaggio a un lato, pacchetto
    - LEGGIMI, FIRMWARE, VERIFICA aggiornati alla rev 2.2 (due schede, JLCPCB,
    spessori, prova della moneta, cavo micro-coassiale a 40 fili)
    - REPORT_rev2.2 con lo stato al 28/10/2026: schede sbrogliate, DRC/ERC 0,
    dime provate, ricettacolo eDP C5160883 a magazzino
    - export_prod: BOM/CPL JLCPCB anche a un lato (Economic) per le rev 2.2
    - README: checklist riordinata, versione v2.2.0-rc1
    - pacchetto x210ai_iso_adapter_kicad_rev2.2.zip
    [x210ai_boardA-B_Cu.gbl, x210ai_boardA-B_Mask.gbs, x210ai_boardA-B_Paste.gbp, x210ai_boardA-B_Silkscreen.gbo, x210ai_boardA-Edge_Cuts.gm1, x210ai_boardA-F_Cu.gtl, x210ai_boardA-F_Mask.gts, x210ai_boardA-F_Paste.gtp]
2026-10-28 Cavo eDP: 1-N, 150 o 200 mm, fornitura su misura da LCSC
    - CABLE_SPEC: lunghezza 150/200 mm (I-PEX 81422-100B-02-D come riferimento a
    200 mm), requisiti del preventivo LCSC Custom Cables, opzione con curva a 90°,
    regola sopra/sotto: solo una piega che capovolge il cavo cambia il tipo
    - README, REPORT, LEGGIMI allineati; pacchetto rigenerato
2026-10-28 Cavo: preventivo per 1-N e 1-1, il progetto resta 1-N
2026-10-28 Board B a scalino: flessibile 4 strati, sbrogliata, produzione JLCPCB
    - Board B a sandwich scartata (sopra la spina della tastiera meno di 1,67 mm):
    gradino alto con la spina J2 su BTB_R_CONN1, J4 verso il palmrest e Q2/Q3/
    R13/R14; scalino flessibile di 1,5 mm; gradino basso con il ricettacolo J1
    della tastiera a 25 gradi
    - ingombri dalla cornice di misura fotografata (gen_dima_scala.py), quadrato
    bianco come zona vietata; dima a scalino provata e legenda di tutti i
    componenti delle due schede
    - flessibile 4 strati (a 2 strati J1-J4 non si sbroglia), irrigidimenti su
    User.1, zona di piega senza via, uscite di J1 pre-instradate
    - ERC 0, DRC 0, 0 non connessi, schema = PCB; DFM e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
    [01_piazzato.kicad_pcb, 02_sbrogliato.kicad_pcb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]
2026-10-28 README: Board B in sospeso (flessibile 4 strati troppo costoso), cavo in attesa di LCSC
2026-10-31 Render: PNG 2D top/bottom e 3D di Board A e B in render/
    - Viste 2D dei layer (40 px/mm) con gen2/render.py: boardA_top/bottom.png, boardB_top/bottom.png
    - Render 3D con kicad-cli pcb render (1600x900, perspektivo): boardA/B_3d_top/bottom.png
    - README: nuova sezione Render che punta a render/
2026-10-31 README: render di Board A e B visibili inline (3D top/bottom + layer 2D)
2026-11-02 Foto 02/11/2026 con dima millimetrata in riferimenti/misure/: rettificata in coordinate dima, ostacoli misurati e zona libera per la scheda a giro del quadrato bianco
2026-11-02 Dima di prova 1:1 scheda a giro del quadrato bianco (doc/x210ai_dima_giro_1a1.pdf, gen2/gen_dima_giro.py)
    Forma a L: base 61,5 x 18,9 mm sotto il quadrato bianco + braccio destro 17,5 x 19,3 mm
    nella zona libera 18 x 54 mm. Allineamento su BTB_R_CONN1 (0,0), ostacoli e quadrato bianco
    disegnati; scala verificata 1:1 (righello 50 mm).
2026-11-02 Quadrato bianco: lato corto 33 mm (calibro 02/11), dims 39,25 x 33 mm (y -40,2..-7,2); dima giro rigenerata
2026-11-02 Dima giro: corretta la forma a L (mancava la base y -6,7..12,2); verifica automatica distanze dagli ostacoli
2026-11-02 Dima giro: fix ordine box() nella verifica automatica distanze
    [gen_dima_giro.py]
2026-11-02 Foto 02/11 spostata da root in riferimenti/misure/ (era duplicata dopo il rebase)
2026-11-02 Rev 2.3: dima a C (scheda unica che aggira il quadrato bianco: giu' da BTB, sotto il quadrato, componenti RP2040 a sinistra); foto 19/10 in riferimenti/misure/
2026-11-02 Dime giro: tre versioni (L, C, C2) in doc/; C2 mette le componenti SOPRA il quadrato (lato opposto a BTB), passaggio a destra
2026-11-02 Dima giro C3: passaggio a SINISTRA del quadrato (tra slot SIM e quadrato), componenti sopra il quadrato (lato opposto a BTB)
2026-11-02 Dima giro C4: scheda ingrossata (base piena 61,9x18,9 mm sotto il quadrato, niente ponte sottile); passaggio sinistra, componenti sopra il quadrato
2026-11-02 Dima giro C4 flip180: forma ruotata di 180 gradi (portrait e landscape), --flip180 in gen_dima_giro.py
    [gen_dima_giro.py]
2026-11-02 Dima giro C5: margine 2 mm dal quadrato bianco (base a y=-5,2, R4 a y=-42,2); vicino allo slot SIM la scheda scende di altri 2 mm (fino a y=-24,9)
2026-11-02 Dima giro: tornata alla C4 in portrait (la rotazione 90 gradi rompeva la posizione); --rot90ccw resta opzionale ma non usata
2026-11-02 Board C (rev 2.3): dima rinominata in doc/x210ai_dima_boardC_1a1.pdf, documentazione aggiornata (README, LEGGIMI, report misure)
2026-11-02 Board C dima v2: ruotata 90 gradi in senso antiorario (tutte le componenti ruotate insieme), doc/x210ai_dima_boardC_v2_1a1.pdf; v1 resta boardC_1a1.pdf
2026-11-02 Board C dima v2 corretta: oggetti (board, quadrato, connettori, riferimenti) ruotati di 90 gradi antiorario nelle coordinate dima, pagina portrait; prima ruotava la pagina nel senso sbagliato
2026-11-02 Fix dima v2: rettangoli (ostacoli, J2, zona BTB) ora ruotati sui 4 vertici, non con width/height fisse - prima erano sballati nella rotazione
    [gen_dima_giro.py]
2026-11-02 Board C dima v3: dalla v2 (ruotata 90 gradi antiorario), tagliati i due lati superiores della U fino a 3 mm sotto la parte superiore del quadrato bianco (x=9 mm in coordinate dima); area 2134 mm2
2026-11-02 Board C dima v4: da v3, invade lo slot SIM di 2,2 mm (R3 x=-42,2), parte bassa della U tagliata di 2 mm (R1 y max 10,2), lato sinistro allargato di 7 mm (R4 y min -67); area 2545 mm2
2026-11-02 Parsing foto 02/11: nomi ostacoli corretti (slot SIM = colonna x -54..-42 y -12,5..4,3; 3 connettori FPC in alto y -26..-14); vecchio rettangolo 'slot SIM' rimosso; dima v3 rigenerata
2026-11-02 Salva contesto sessione 02/11/2026 (doc/CONTESTO_20261102.md): misure verticali, parsing foto, stato dime Board C (v3 buona), prossimi passi
