marcocancarini/x210ai-rp2040-adapter/(notices)

Notices in the files:
fw3/ThinkPad_RP2040_Keyboard/ThinkPad_RP2040_Keyboard.ino:
modify it under the terms of the GNU General Public License a
published by the Free Software Foundation, version 3.
